jrgdiaz/HHW_HackConRD2024/HackconRD_Badge.kicad_sch

## KiCad design HackconRD_Badge.kicad_sch (2024-03-08)

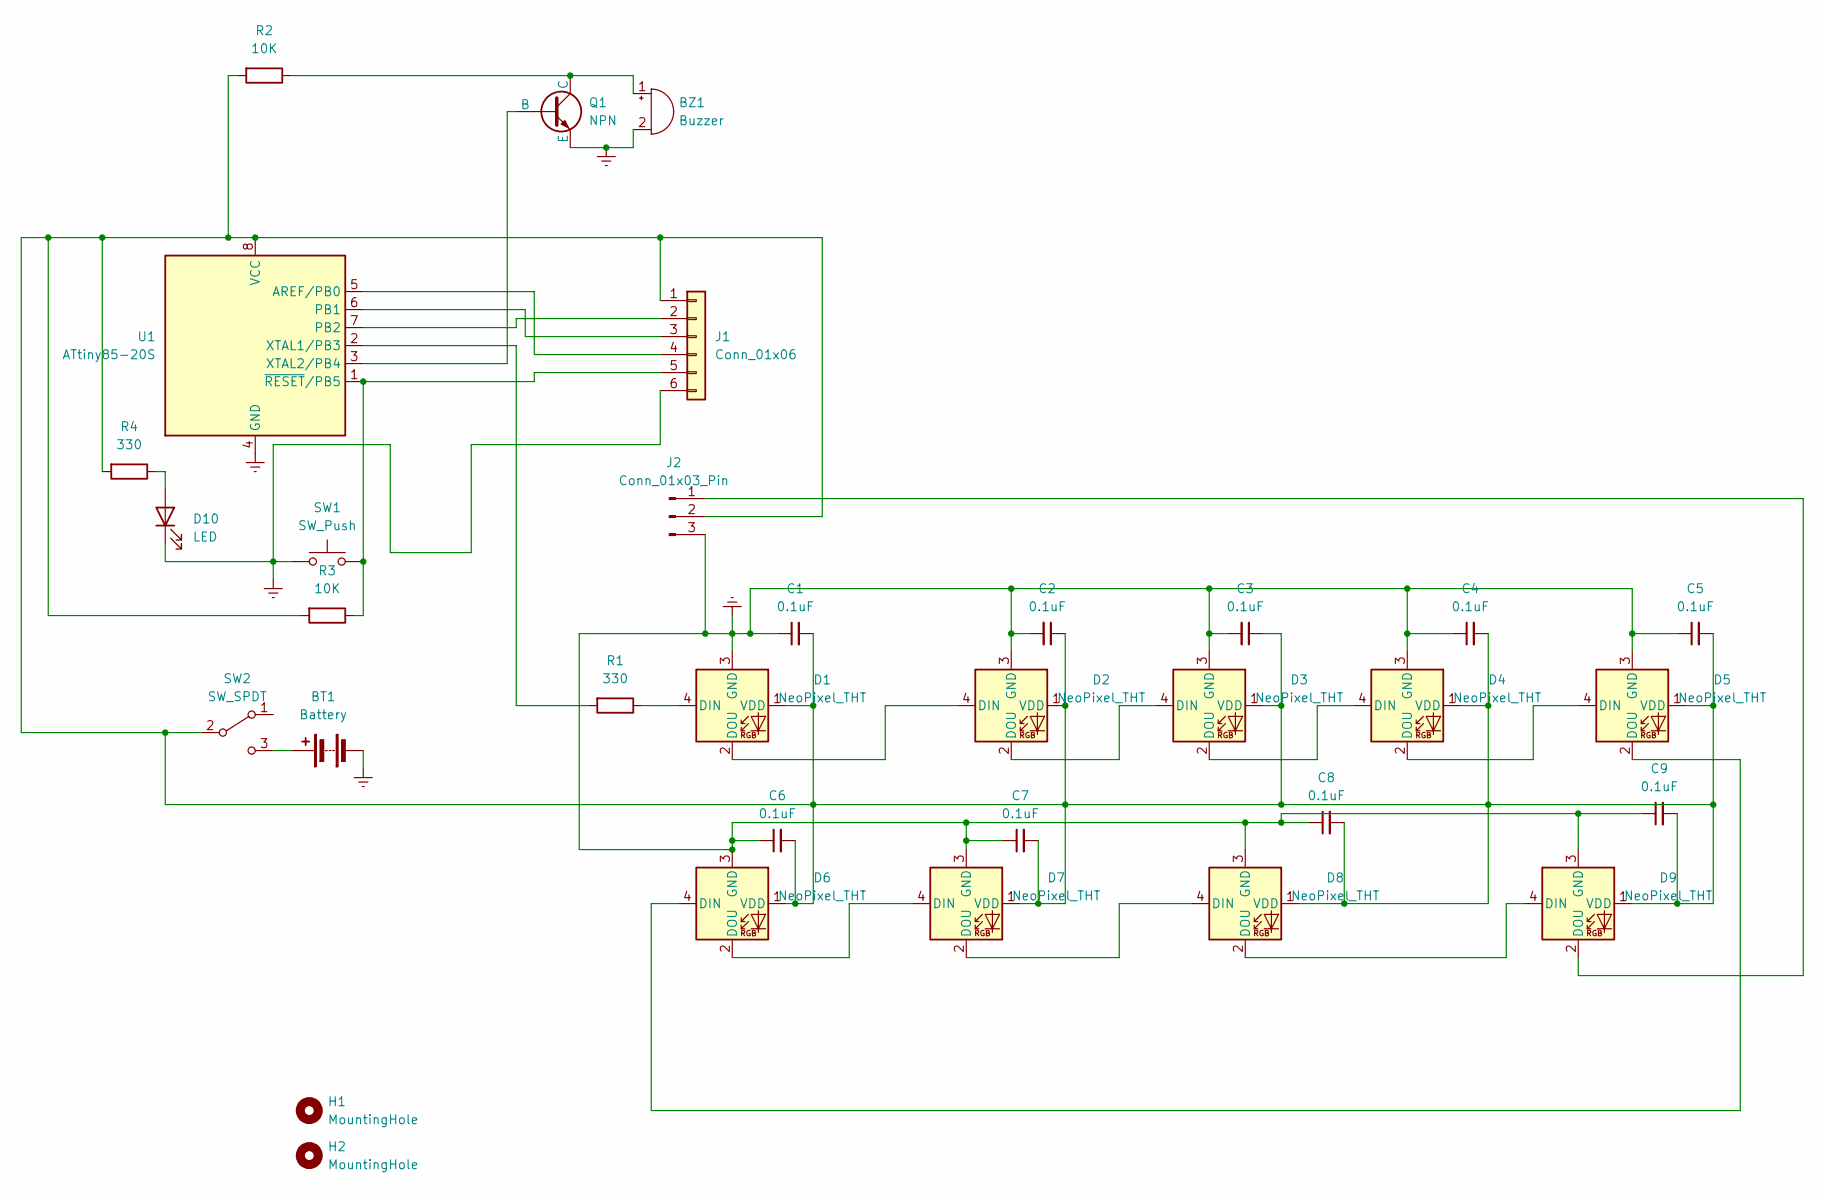
[picture p1: schematic HackconRD_Badge.kicad_sch]

Parts:
BT1: Battery; BatteryHolder_Keystone_2479_3xAAA
BZ1: Buzzer; Buzzer_CUI_CPT-9019S-SMT
C1, C2, C3, C4, C5, C6, C7, C8, C9: 0.1uF; C_0603_1608Metric
D1, D2, D3, D4, D5, D6, D7, D8, D9: NeoPixel_THT; LED_WS2812B_PLCC4_5.0x5.0mm_P3.2mm
D10: LED; LED_0603_1608Metric
H1, H2: MountingHole; MountingHole_4.5mm
J1: Conn_01x06; PinHeader_2x03_P2.54mm_Vertical
J2: Conn_01x03_Pin; PinHeader_1x03_P2.54mm_Vertical
Q1: NPN; TSOT-23
R1, R4: 330; R_0603_1608Metric
R2, R3: 10K; R_0603_1608Metric
SW1: SW_Push; SW_Push_1P1T_NO_6x6mm_H9.5mm
SW2: SW_SPDT; SW_SPDT_PCM12
U1: ATtiny85-20S; SOIC-8W_5.3x5.3mm_P1.27mm

Connections:
Earth: BT1.2 (-), BZ1.2 (+), C1.1, C2.2, C3.2, C4.1, C5.1, C6.1, C7.1, C8.1, C9.1, D1.3 (GND), D2.3 (GND), D3.3 (GND), D4.3 (GND), D5.3 (GND), D6.3 (GND), D7.3 (GND), D8.3 (GND), D9.3 (GND), D10.1 (K), J1.6, J2.3, Q1.2 (E), SW1.1, U1.4 (GND)
unnamed: BT1.1 (+), SW2.3 (C)
unnamed: BZ1.1 (-), Q1.3 (C), R2.1
unnamed: C1.2, C2.1, C3.1, C4.2, C5.2, C6.2, C7.2, C8.2, C9.2, D1.1 (VDD), D2.1 (VDD), D3.1 (VDD), D4.1 (VDD), D5.1 (VDD), D6.1 (VDD), D7.1 (VDD), D8.1 (VDD), D9.1 (VDD), J1.1, J2.2, R2.2, R3.2, R4.2, SW2.2 (B), U1.8 (VCC)
unnamed: D1.2 (DOU), D2.4 (DIN)
unnamed: D1.4 (DIN), R1.1
unnamed: D2.2 (DOU), D3.4 (DIN)
unnamed: D3.2 (DOU), D4.4 (DIN)
unnamed: D4.2 (DOU), D5.4 (DIN)
unnamed: D5.2 (DOU), D6.4 (DIN)
unnamed: D6.2 (DOU), D7.4 (DIN)
unnamed: D7.2 (DOU), D8.4 (DIN)
unnamed: D8.2 (DOU), D9.4 (DIN)
unnamed: D9.2 (DOU), J2.1
unnamed: D10.2 (A), R4.1
unnamed: J1.2, U1.7 (PB2)
unnamed: J1.3, U1.6 (PB1)
unnamed: J1.4, U1.5 (AREF/PB0)
unnamed: J1.5, R3.1, SW1.2, U1.1 (~RESET/PB5)
unnamed: Q1.1 (B), U1.3 (XTAL2/PB4)
unnamed: R1.2, U1.2 (XTAL1/PB3)
